badrbouslikhin/Beluga/01_Schematics_BOM_Layout_Fabrication/Report Board Stack/SB7043.xls

Board Stack Report
Stack Up |  | Layer Stack
Layer | Cirly_4-Layers | Name | Material | Thickness | Constant
1 |  | Top Paste
2 |  | Top Overlay
3 |  | Top Solder | Solder Resist | 0,40mil | 3,5
4 |  | Top Layer | Copper | 0,67mil
5 |  | Dielectric1 |  | 14,17mil | 4,2
6 |  | GND | Copper | 1,38mil
7 |  | Dielectric 2 | FR4 | 27,95mil | 4,2
8 |  | Signal Layer 1 | Copper | 1,38mil
9 |  | Dielectric 3 |  | 14,17mil | 4,2
10 |  | Bottom Layer | Copper | 0,67mil
11 |  | Bottom Solder | Solder Resist | 0,40mil | 3,5
12 |  | Bottom Overlay
13 |  | Bottom Paste
 | Height : 61,19mil
