badrbouslikhin/Beluga/02_STM32CubeMX/Beluga.ioc

Mcu.UserName=STM32F429ZITx
PA0/WKUP.Signal=UART4_TX
PA1.Signal=UART4_RX
PA10.Signal=USART1_RX
PA11.Signal=LTDC_R4
PA12.Signal=LTDC_R5
PA13.Signal=SYS_JTMS-SWDIO
PA14.Signal=SYS_JTCK-SWCLK
PA15.Signal=I2S3_WS
PA3.Signal=LTDC_B5
PA4.Signal=LTDC_VSYNC
PA5.Signal=COMP_DAC2_group
PA6.Signal=LTDC_G2
PA8.GPIO_Label=DISP
PA8.Signal=GPIO_Output
PA9.Signal=USART1_TX
PB0.Signal=LTDC_R3
PB1.Signal=LTDC_R6
PB10.Signal=LTDC_G4
PB11.Signal=LTDC_G5
PB12.Signal=USB_OTG_HS_ID
PB13.Signal=USB_OTG_HS_VBUS
PB14.Signal=USB_OTG_HS_DM
PB15.Signal=USB_OTG_HS_DP
PB2/BOOT1.GPIO_Label=\#RY/BY
PB2/BOOT1.Signal=GPIO_Input
PB3.Signal=I2S3_CK
PB4.GPIO_Label=RESET\#
PB4.Signal=GPIO_Output
PB5.Signal=I2S3_SD
PB6.Signal=I2C1_SCL
PB7.Signal=I2C1_SDA
PB8.Signal=LTDC_B6
PB9.Signal=LTDC_B7
PC0.Signal=FMC_SDNWE
PC10.Signal=LTDC_R2
PC11.GPIO_Label=Input_Power_Fault
PC11.Signal=GPIO_Input
PC12.GPIO_Label=Input_Power_Enable
PC12.Signal=GPIO_Output
PC2.Signal=FMC_SDNE0
PC3.Signal=FMC_SDCKE0
PC4.GPIO_Label=LED1
PC4.Signal=GPIO_Output
PC5.GPIO_Label=LED2
PC5.Signal=GPIO_Output
PC6.Signal=LTDC_HSYNC
PC7.Signal=LTDC_G6
PC8.GPIO_Label=OTG_Power_Fault
PC8.Signal=GPIO_Input
PC9.GPIO_Label=OTG_Power_Enable
PC9.Signal=GPIO_Output
PD0.Signal=FMC_D2_DA2
PD1.Signal=FMC_D3_DA3
PD10.Signal=FMC_D15_DA15
PD11.Signal=FMC_A16_CLE
PD12.Signal=FMC_A17_ALE
PD13.Signal=FMC_A18
PD14.Signal=FMC_D0_DA0
PD15.Signal=FMC_D1_DA1
PD2.GPIO_Label=Backlight_Shutdown
PD2.Signal=GPIO_Output
PD3.Signal=LTDC_G7
PD4.Signal=FMC_NOE
PD5.Signal=FMC_NWE
PD6.Signal=LTDC_B2
PD7.Signal=FMC_NE1
PD8.Signal=FMC_D13_DA13
PD9.Signal=FMC_D14_DA14
PE0.Signal=FMC_NBL0
PE10.Signal=FMC_D7_DA7
PE11.Signal=FMC_D8_DA8
PE12.Signal=FMC_D9_DA9
PE13.Signal=FMC_D10_DA10
PE14.Signal=FMC_D11_DA11
PE15.Signal=FMC_D12_DA12
PE2.Signal=FMC_A23
PE3.Signal=FMC_A19
PE4.Signal=FMC_A20
PE5.Signal=FMC_A21
PE6.Signal=FMC_A22
PE7.Signal=FMC_D4_DA4
PE8.Signal=FMC_D5_DA5
PE9.Signal=FMC_D6_DA6
PF0.Signal=FMC_A0
PF1.Signal=FMC_A1
PF10.Signal=LTDC_DE
PF11.Signal=FMC_SDNRAS
PF12.Signal=FMC_A6
PF13.Signal=FMC_A7
PF14.Signal=FMC_A8
PF15.Signal=FMC_A9
PF2.Signal=FMC_A2
PF3.Signal=FMC_A3
PF4.Signal=FMC_A4
PF5.Signal=FMC_A5
PF7.Signal=SPI5_SCK
PF8.Signal=SPI5_MISO
PF9.Signal=SPI5_MOSI
PG0.Signal=FMC_A10
PG1.Signal=FMC_A11
PG10.Signal=LTDC_G3
PG11.Signal=LTDC_B3
PG12.Signal=LTDC_B4
PG15.Signal=FMC_SDNCAS
PG2.Signal=FMC_A12
PG3.Signal=FMC_A13
PG4.Signal=FMC_A14_BA0
PG5.Signal=FMC_A15_BA1
PG6.Signal=LTDC_R7
PG7.Signal=LTDC_CLK
PG8.Signal=FMC_SDCLK
PH0/OSC_IN.Signal=RCC_OSC_IN
PH1/OSC_OUT.Signal=RCC_OSC_OUT
