badrbouslikhin/Beluga/(commit log)

2015-03-01 Created intial folders hierarchy. Added initial power supplies specification.
    [Power_supplies.xlsx]
2015-03-04 Added a samples requests Excel sheet to keep track of the sample components ordered.
    [Samples_requests.xlsx]
2015-03-09 Ajout des fichiers du Google Drive
    [MB1075 B01 BOM.xls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]
2015-03-09 Added 3V3 DCDC calculs Excel sheet and cleaned up folders.
    [Power_supplies_calculus.xlsx]
2015-03-20 Diagramme pieuvre + fonctions rajouté. Bête à cornes updatée
    [Pieuvre_fonctions.xlsx]
2015-03-20 Bete à corne, pieuvre et fonctions updaté.
    [Pieuvre_fonctions.xlsx]
2015-03-20 Création du phasage et mise à jour des fonctions pieuvre
    [Pieuvre_fonctions.xlsx]
2015-03-22 Gantt complété avec les tâches hardware et bullshit, à revoir Phasage légèrement modifié, revoir la mise en page Analyse de risque crée, reste à rajouter les risques software et faire une revue de ce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
    [Analyse_risques.xlsx]
2015-03-23 Added Altium project hierarchy
    [IO_Peripherals.SchDoc, NOR.SchDoc, PRT_STM32F429ZI_Eval-Board.PrjPcb, Power.SchDoc, RAM.SchDoc, STM32F429ZI.SchDoc, Top_Sheet.SchDoc, USB.SchDoc]
2015-03-24 Ajout de quelques risques
    [Analyse_risques.xlsx]
2015-03-25 Power_supplies_calculus_21V added. Bloc diagram updated.
    [Power_supplies_calculus_21V.xlsx]
2015-03-25 MAJ de la pieuvre pour la batterie Ajout du cycle de vie
2015-03-25 Redimensionnement de la page à la taille des diagrammes
2015-03-25 Redimensionnement pour de vrai cette fois ci
2015-03-26 Ajout d'un backup d'overleaf et du pdf du plan directeur de projet
2015-03-26 DCDC21V shematic finished. Just need to link components to Suppliers. Wurth DCDC21V Inductance Library added.
    [PRT_STM32F429ZI_Eval-Board.PrjPcb, Power.SchDoc]
2015-03-26 DCDC21V Webench simulation files added.
    [2015-03-26_02-24-551.schdoc, 2015-03-26_02-24-56.PcbLib, 2015-03-26_02-24-56.SchLib, webench_design_4015146_2_ad14_sim.PrjPcb, webench_design_4015146_2_ad14_sim.SchDoc, webench_design_4015146_2_ad14_sim.xml]
2015-03-26 DCDC21V and DCDC3V3 calculus updated. They should be more accurate now.
    [Power_supplies_calculus.xlsx, Power_supplies_calculus_21V.xlsx]
2015-04-23 Power sheet finished. Need to do a review. Associated libraries and components added. Simulation files from TI Webench added.
    [2015-04-12_03-12-171.schdoc, 2015-04-12_03-12-18.PcbLib, 2015-04-12_03-12-18.SchLib, Power.SchDoc]
2015-04-25 USB Input Power current limiter calculus Excel sheet added. LTSpice simulation for the command stage of the 21V LED Indicator added. Folders cleaned and reorganized.
    [2015-03-26_02-24-551.schdoc, 2015-03-26_02-24-56.PcbLib, 2015-03-26_02-24-56.SchLib, 2015-04-12_03-12-171.schdoc, 2015-04-12_03-12-18.PcbLib, 2015-04-12_03-12-18.SchLib, Current_Limiter-Calculus.xlsx, Power_Supplies.xlsx]
2015-04-25 Folders cleaning.
    [Power_supplies.xlsx, Power_supplies_calculus.xlsx, Power_supplies_calculus_21V.xlsx]
2015-04-25 Power sheet finished, Power LED indicators added (3V3, 5V and 21V). USB Input power stage added, Current-Limiter added (with corresponding Fault LED indicator). Folders cleaning.
    [PRT_STM32F429ZI_Eval-Board.PrjPcb, Power.SchDoc, STM32F429ZI.SchDoc, USB.SchDoc]
2015-04-25 21V DCDC datasheet updated.
2015-04-26 Oscillator datasheet added. AN : Oscillator design guide for STM8S, STM8A and STM32 microcontrollers added. AN : Getting started with STM32F4xxxx MCU hardware development added.
2015-04-26 21V LED command stage Calculus paper sheet added. Schematics updated, memory (NOR & Flash) libraries created.
    [IO_Peripherals.SchDoc, NOR.SchDoc, PRT_STM32F429ZI_Eval-Board.PrjPcb, Power.SchDoc, RAM.SchDoc, STM32F429ZI.SchDoc, Top_Sheet.SchDoc, USB.SchDoc]
2015-04-27 RAM schematic complete. NOR schematic ongoing.
    [IO_Peripherals.SchDoc, NOR.SchDoc, Power.SchDoc, RAM.SchDoc, STM32F429ZI.SchDoc, Top_Sheet.SchDoc, USB.SchDoc]
2015-04-27 NOR added, nearly complete. USB OTG added, nearly complete. Need to review some compilation errors and unmatched Ports. STM32CubeMX project added, helpful for pin viewing and finding conflicts. Possi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
    [IO_Peripherals.SchDoc, NOR.SchDoc, PRT_STM32F429ZI_Eval-Board.PrjPcb, Power.SchDoc, RAM.SchDoc, STM32F429ZI.SchDoc, Top_Sheet.SchDoc, USB.SchDoc]
2015-04-28 NOR, USB OTG finished. Schematics nearly finished. Need a global review. LCD on hold. STM32CubeMX updated to meet the actual pinout.
    [IO_Peripherals.SchDoc, NOR.SchDoc, STM32F429ZI.SchDoc, Top_Sheet.SchDoc, USB.SchDoc]
2015-04-29 FFC LCD connector chosen and library added. LCD schematic ongoing. Possible conflict with RY/BY# memory's signal. To investigate further.
    [IO_Peripherals.SchDoc, MB1075 B01 BOM.xls, PRT_STM32F429ZI_Eval-Board.PrjPcb, STM32F429ZI.SchDoc, Top_Sheet.SchDoc]
2015-04-30 Schematic over. Need a global review. STM32429I-EVAL schematics added.
    [Audio.SchDoc, CAN&MicroSDD&IO_Expandor.SchDoc, Ethernet.SchDoc, ExtensionConnector.SchDoc, IO_Peripherals.SchDoc, JTAG&Trace.SchDoc, LCD&Camera&Connectors.SchDoc, MB1046.PrjPCB]
2015-05-02 FMC_NWAIT conflict with LTDC_B2 solved by connecting LTDC_B2 to PD6 et keeping an optional 0R resistance in case FMC_NWAIT is absolutely needed. Schematics pinout reviewed. Corrected some errors. STM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
    [IO_Peripherals.SchDoc, NOR.SchDoc, PRT_STM32F429ZI_Eval-Board.PrjPcb, RAM.SchDoc, STM32F429ZI.SchDoc, Top_Sheet.SchDoc, USB.SchDoc]
2015-05-02 Components designators updated. BOM added, work ongoing.
    [IO_Peripherals.SchDoc, NOR.SchDoc, Power.SchDoc, RAM.SchDoc, STM32F429ZI.SchDoc, USB.SchDoc]
2015-05-02 BOM Optimization done. BOM for 1 board and for 2 boards added. Hynix RAM IC no more available. Need to replace it.
    [IO_Peripherals.SchDoc, NOR.SchDoc, PRT_STM32F429ZI_Eval-Board.PrjPcb, PRT_STM32F429ZI_Eval-Board.xls, PRT_STM32F429ZI_Eval-Boardx2.xls, Power.SchDoc, RAM.SchDoc, STM32F429ZI.SchDoc]
2015-05-03 RAM IC updated. Micron choosed.
    [IO_Peripherals.SchDoc, NOR.SchDoc, Power.SchDoc, RAM.SchDoc, STM32F429ZI.SchDoc, Top_Sheet.SchDoc, USB.SchDoc]
2015-05-03 LED current resistors adjusted due to TPS2552DBVT Fault current sink limit (current lowered to 10mA instead of 20mA before). Started PNP simulation command stage. To finish and implement later. Not m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
    [Power.SchDoc, STM32F429ZI.SchDoc, Top_Sheet.SchDoc, USB.SchDoc]
2015-05-03 Small designators update.
    [Top_Sheet.SchDoc, USB.SchDoc]
2015-05-03 2 User LEDs added. STM32CubeMX project updated to meet the schematics.
    [IO_Peripherals.SchDoc, STM32F429ZI.SchDoc, Top_Sheet.SchDoc, USB.SchDoc]
2015-05-04 Capacitor modified for BOM coherence.
    [PRT_STM32F429ZI_Eval-Board.xls, Power.SchDoc, STM32F429ZI.SchDoc]
2015-05-10 Minor schematics updated. Layout started. STM32CubeMX updated (BOOT1 removed).
    [IO_Peripherals.SchDoc, NOR.SchDoc, PRT_STM32F429ZI_Eval-Board.PrjPcb, RAM.SchDoc, SB7043.PcbDoc, STM32F429ZI.SchDoc, Top_Sheet.SchDoc, USB.SchDoc]
2015-05-18 3V3 FB pin schematic corrected. NOR #BYTE signal connected to ground and unconnected from MCU. RY/BY# connected to GPIO PB2. Components.txt obsolete, deleted. Some other minors modifications.
    [IO_Peripherals.SchDoc, NOR.SchDoc, Power.SchDoc, RAM.SchDoc, STM32F429ZI.SchDoc, Top_Sheet.SchDoc]
2015-05-18 Add test placement of SDRAM and NOR
    [Placement_Douglas_RAM_NOR_dirty_test.PcbDoc]
2015-05-21 Update Anootations added
    [Power.SchDoc]
2015-05-23 Initial component placement over. Routing ongoing.
    [SB7043.PcbDoc]
2015-05-24 Routing ongoing.
    [SB7043.PcbDoc, Top_Sheet.SchDoc]
2015-05-26 Routing ongoing...
    [SB7043.PcbDoc]
2015-06-06 Schematic title bloc updated.
    [IO_Peripherals.SchDoc, NOR.SchDoc, Power.SchDoc, RAM.SchDoc, STM32F429ZI.SchDoc, Top_Sheet.SchDoc, USB.SchDoc]
2015-06-07 Add Overleaf Latex sources for Plan directeur de projet and Rapport final
    [Analyse_risques.xlsx, Pieuvre_fonctions.xlsx]
2015-06-07 Remove AF directory, replaced it with PlanDirecteurDeProjet
    [Analyse_risques.xlsx, Pieuvre_fonctions.xlsx]
2015-06-07 Add Power Point presentation
2015-06-07 BOM updated. Template added.
    [PRT_STM32F429ZI_Eval-Board.PrjPcb, PRT_STM32F429ZI_Eval-Board.xls, PRT_STM32F429ZI_Eval-Boardx2.xls]
2015-06-07 Correction de certaines slides
2015-07-09 Routing ongoing.. Little cleanup.
    [PRT_STM32F429ZI_Eval-Board.PrjPcb, SB7043.PcbDoc]
2015-07-09 Routing ongoig. LCD routing left...
    [PRT_STM32F429ZI_Eval-Board.PrjPcb, SB7043.PcbDoc, STM32F429ZI.SchDoc, USB.SchDoc]
2015-07-10 Slight change concerning the differential pair directive
    [USB.SchDoc]
2015-07-10 NONE WORKING PCB VERSION, R-LCD NETS MISSING. COMMITED JUST IN ORDER TO REVERT IF NECESSARY.
    [SB7043.PcbDoc]
2015-07-10 Deleted MCU bus nets from schematics. Solved duplicate net names (deleted no-ERC directives from concerned signals), PCB synchronization and missing nets/wrong connectivity from PCB issues.
    [SB7043.PcbDoc, STM32F429ZI.SchDoc, Top_Sheet.SchDoc]
2015-07-11 LCD signals routing nearly complete. Overall routing @ about 85%.
    [PRT_STM32F429ZI_Eval-Board.PrjPcb, SB7043.PcbDoc]
2015-07-11 LCD routing complete. Power planes and GND connections need some polishing. Some GPIOs to be made accessible.
    [SB7043.PcbDoc]
2015-07-14 Schematics updated to add I2C, I2S and SPI peripherals. Ideally, need to add 3 ADC pins. Routing ongoing and nearly over, need net equalization, polishing and verification. STM32CubeMX updated to mee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
    [IO_Peripherals.SchDoc, SB7043.PcbDoc, STM32F429ZI.SchDoc, Top_Sheet.SchDoc]
2015-07-14 Routing over. Needs net equ. DRC and polishing.
    [IO_Peripherals.SchDoc, SB7043.PcbDoc, STM32F429ZI.SchDoc, Top_Sheet.SchDoc]
2015-07-14 STM32CubeMX updated to meed current design (UART added)
2015-07-15 Silk screen updated. Still need DRC, net equ. and some polishing.
    [IO_Peripherals.SchDoc, SB7043.PcbDoc]
2015-07-15 IO_Peripherals sheet updated. Added supplier links to the headers.
    [IO_Peripherals.SchDoc, PRT_STM32F429ZI_Eval-Board.PrjPcb]
2015-07-16 Cleanup. BOM updated, PCB rule checked, net length equalization dropped, note needed and too complicated to do in such small board, polishing done. Needs review and Test points.
    [PRT_STM32F429ZI_Eval-Board.PrjPcb, PRT_STM32F429ZI_Eval-Board.xls, PRT_STM32F429ZI_Eval-Board_Samples_Considered.xls, Placement_Douglas_RAM_NOR_dirty_test.PcbDoc, SB7043.PcbDoc, Top_Sheet.SchDoc]
2015-07-16 Added test points on schematics and PCB, added corresponding libraries.
    [PRT_STM32F429ZI_Eval-Board.PrjPcb, Power.SchDoc, SB7043.PcbDoc, USB.SchDoc]
2015-07-17 Updated Top overlay with authors, board name, date and version.
    [SB7043.PcbDoc]
2015-07-20 Created Output Job file, generated Gerbers and NCDrill files for fab and PDF containing schematics and prints of the PCB.
    [SB7043.GBL, SB7043.GBO, SB7043.GBS, SB7043.GKO, SB7043.GTL, SB7043.GTO, SB7043.GTS]
2015-07-20 Stackup added.
    [SB7043.xls]
2015-07-20 Project file and output job file updated. Minor modifications.
    [PRT_STM32F429ZI_Eval-Board.PrjPcb]
2015-08-04 PCB layout updated to simplify fabrication process. GND - Bottom Layer is no longer a drill pair. DRC, Gerbers and NCDrill files updated.
    [PRT_STM32F429ZI_Eval-Board.PrjPcb, SB7043.PcbDoc, SB7043.xls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]
2015-08-04 Stackup report generated using metric units.
    [SB7043.xls]
2015-08-04 Via aspect ratio Excel calculation sheet added.
    [Via_Aspect-Ratio.xls]
2015-08-04 Via_Aspect-Ratio.xls minor updates.
    [Via_Aspect-Ratio.xls]
2015-09-20 Add pinout info for STM32F429 Discovery board
2015-09-20 Add details on STM32F429 Discovery
2015-09-27 Cleaning of the repo.
    [Analyse_risques.xlsx, Pieuvre_fonctions.xlsx]
2015-09-27 Repository cleaning
    [Audio.SchDoc, CAN&MicroSDD&IO_Expandor.SchDoc, Ethernet.SchDoc, ExtensionConnector.SchDoc, JTAG&Trace.SchDoc, LCD&Camera&Connectors.SchDoc, MB1046.PrjPCB, MB1046.SCHLIB]
2015-09-27 Project cleaning
    [PRT_STM32F429ZI_Eval-Board.xls, PRT_STM32F429ZI_Eval-Board_Samples_Considered.xls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]
